thanh-pt/GraduationThesis/Doccument/thePrizeOfThesis.txt

A4988 80+25 = 			105
wire test: 			20
MPU6050 			50
2 DC moto and wheels: 		70
3 5x7 board: 			10
2 wheels robot V3: 		190
2 latches of wheels: 		56
STM32f103 			80
Bluetooth HC05 			85
Thiec han 			50
L293x2 				40
6 5x7 board: 			12
Dip 18 for ic: 			2.8
LM1117: 			7
Tụ Tantalum: 			5
Đế pin: 			10
Pin: 				40
In mạch: 			20
