thanh-pt/GraduationThesis/CircuitDesign/BalanceCarCircuit.PcbDoc.htm

Reporting Options

# File in Previous Format

Date | : | 04/07/2018
Time | : | 09:44:34
Filename | : | E:\MyWork\GraduationThesis\CircuitDesign\BalanceCarCircuit.PcbDoc

Version | Warning
Release 12 | CAUTION - Air Gap Width previously controlled by Clearance rule is now controlled by Polygon Connect Style rule's newly introduced Air Gap Width (set to default value). Suggest reviewing each Polygon Connect Style rule's Air Gap Width attribute for correctness.
Release 13 | CAUTION - Silkscreen Over Component Pads Rules are converted to Silk To Solder Mask Clearance Rules. Suggest examining rule scopes for accuracy.

This file was generated by an earlier version of the software
