thanh-pt/GraduationThesis/Slide/GraduationThesisSlide.pptx

ĐẠI HỌC QUỐC GIA HÀ NỘI
TRƯỜNG ĐẠI HỌC CÔNG NGHỆ
LỄ BẢO VỆ KHÓA LUẬN TỐT NGHIỆP ĐẠI HỌC CHÍNH QUY
TRƯỜNG ĐẠI HỌC CÔNG NGHỆ ĐỢT 1 2018
NGHIÊN CỨU, THIẾT KẾ XE TỰ CÂN BẰNG
SỬ DỤNG CẢM BIẾN GIA TỐC 3 TRỤC
VÀ VI ĐIỀU KHIỂN 32 BIT
Sinh viên: Phạm Tiến Thành
Giảng viên hướng dẫn: ThS. Hoàng Văn Mạnh

## Mở đầu

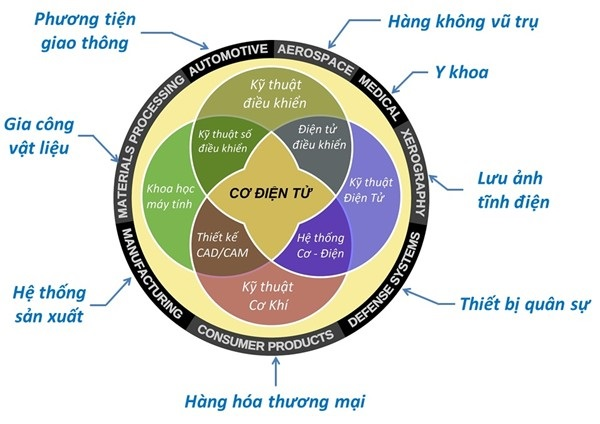
[picture p1: figure]
Image result for CÆ¡ Ä iá» n tá»

## Mở đầu

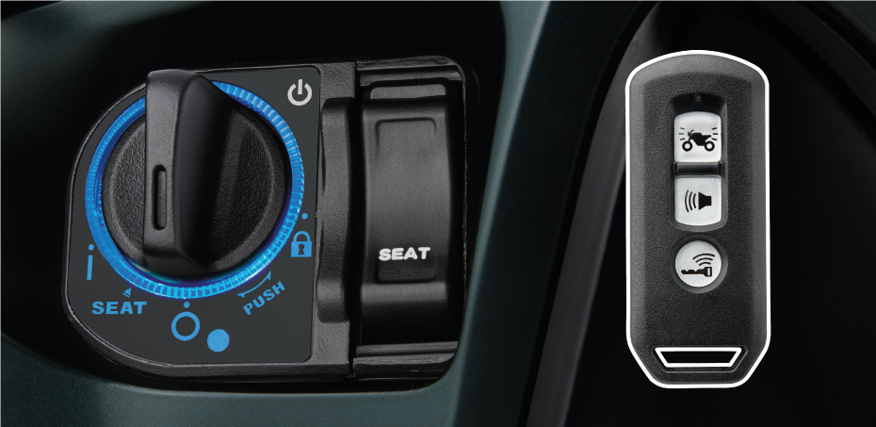
[picture p2: figure]
Image result for xe mÃ¡y thÃ´ng minh
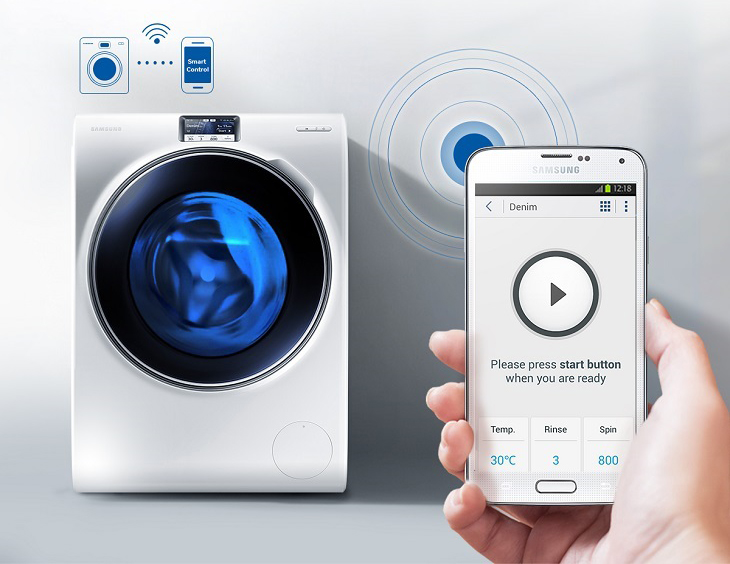
[picture p3: figure]
Image result for mÃ¡y giáº·t thÃ´ng minh
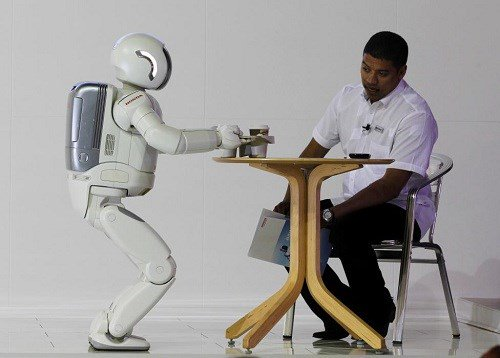
[picture p4: figure]
Image result for robot thÃ´ng minh

## Cảm biến

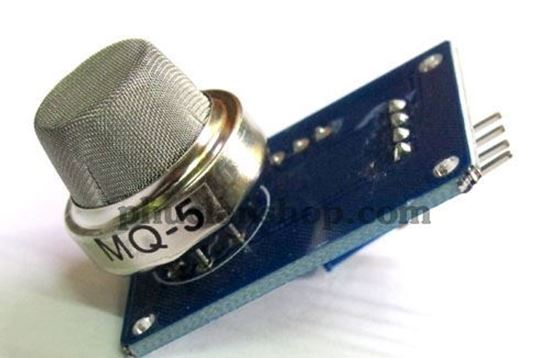
[picture p5: figure]
Image result for cáº£m biáº¿n
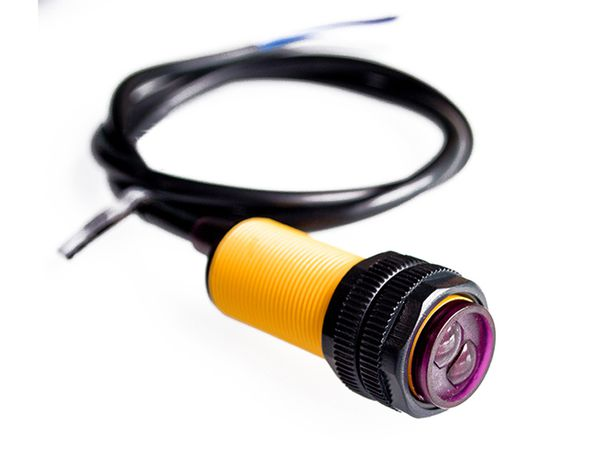
[picture p6: figure]
Image result for cáº£m biáº¿n
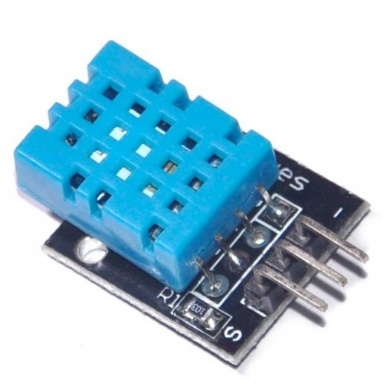
[picture p7: figure]
Image result for cáº£m biáº¿n
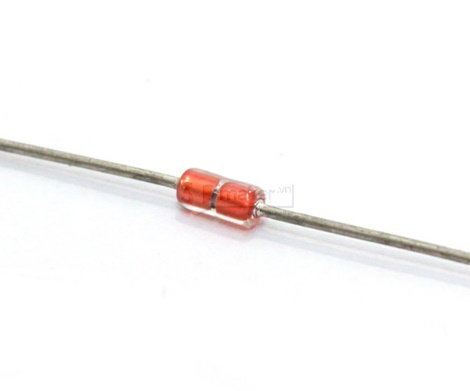
[picture p8: figure]
Image result for cáº£m biáº¿n
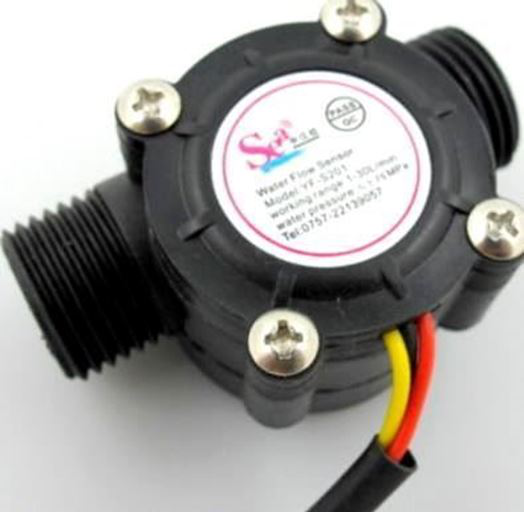
[picture p9: figure]
Image result for cáº£m biáº¿n
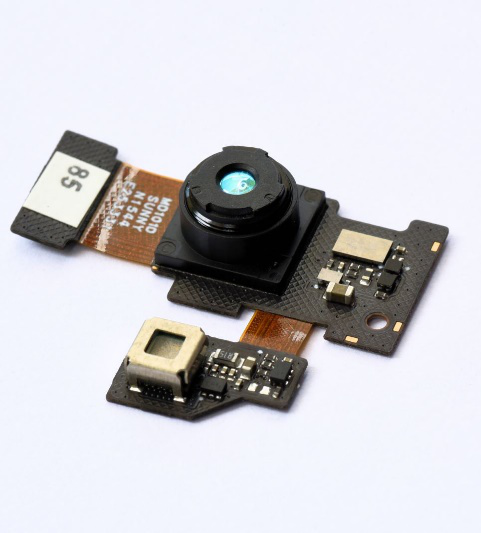
[picture p10: figure]
Image result for cáº£m biáº¿n
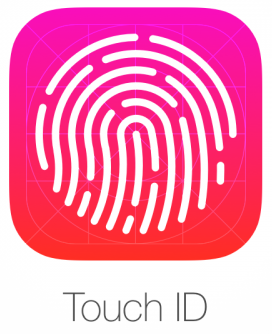
[picture p11: figure]
Image result for cáº£m biáº¿n vÃ¢n tay
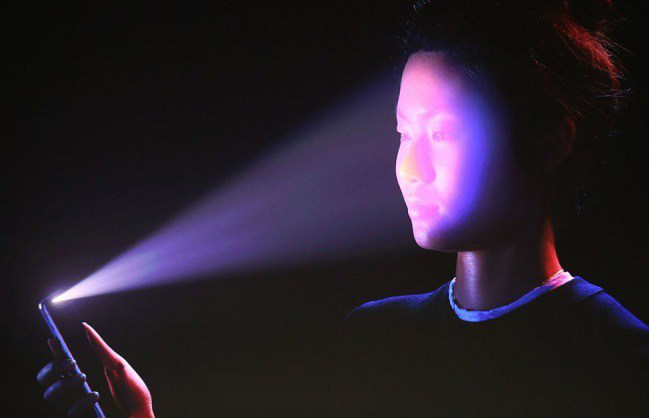
[picture p12: figure]
Image result for cáº£m biáº¿n face id
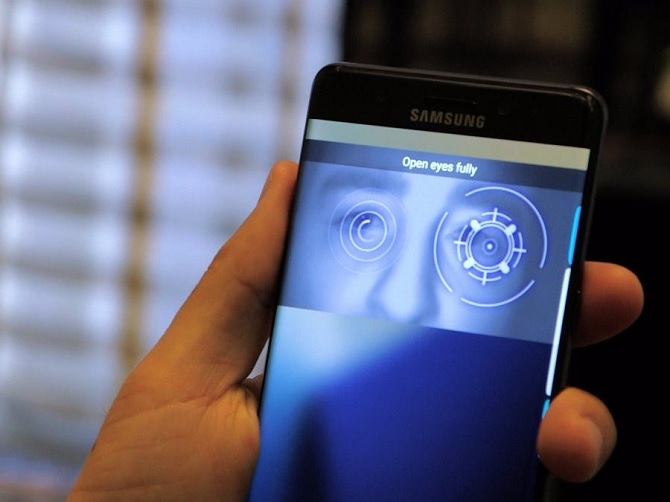
[picture p13: figure]
Image result for cáº£m biáº¿n má» ng máº¯t

## Cảm biến gia tốc 3 trục

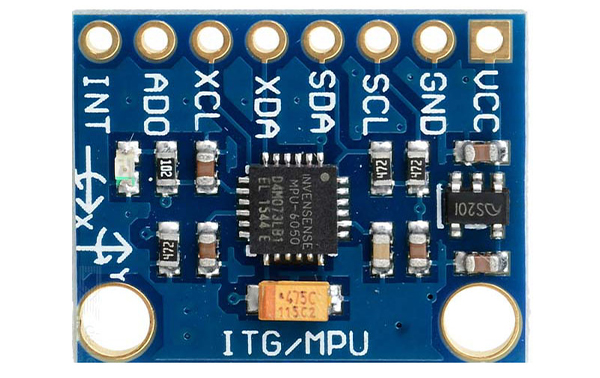
[picture p14: figure]
Image result for cáº£m biáº¿n gia tá» c 3 trá»¥c

## Vi điều khiển

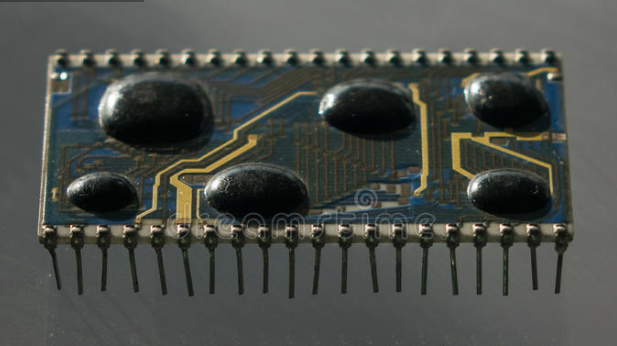
[picture p15: figure]
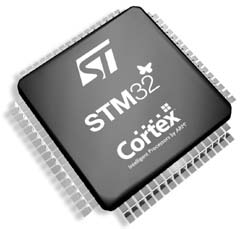
[picture p16: figure]
Image result for 32bit microcontroller

## Vi điều khiển 32 bit

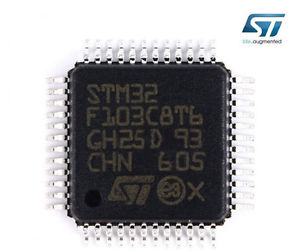
[picture p17: figure]
Image result for stm32f103c8t6 chip only

## Vi điều khiển 32 bit

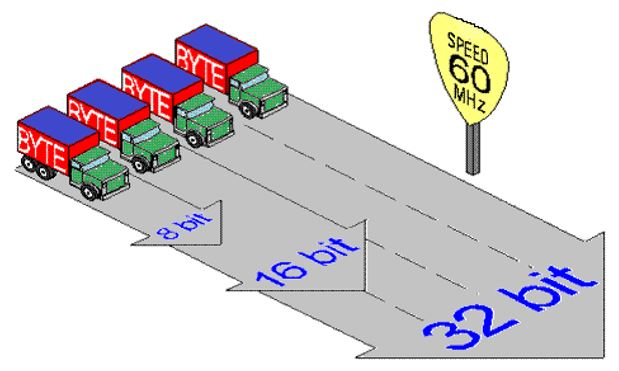
[picture p18: figure]
Architecture Valuable Idea 8 Bit Microcontroller Architecture And 32 Microcontrollers Theembeddedguy Com MCU WellSuited Design 8 Bit Microcontroller Architecture

## Vi điều khiển 32 bit

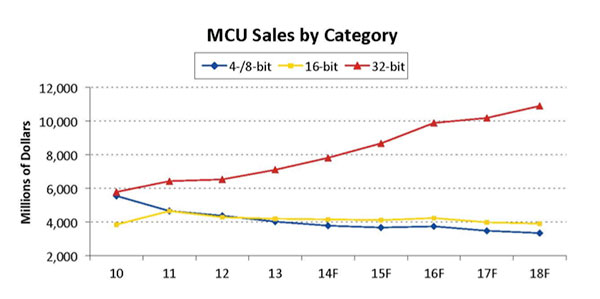
[picture p19: figure]
fig1

## Vi điều khiển 32 bit

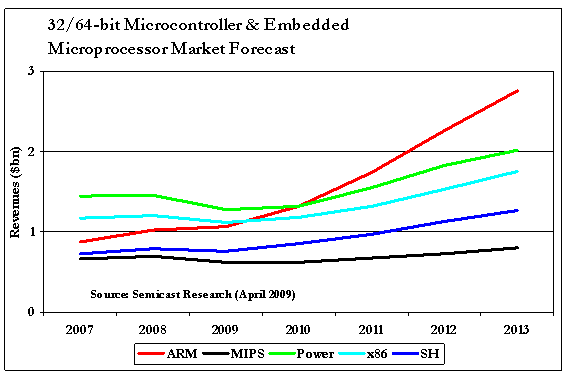
[picture p20: figure]
Architecture Shocking Ideas 8 Bit Microcontroller Architecture ARM Forecast To Become The Leading 32 Source Material For This News Release Is Taken From Semicast Report 64 Microcontrollers Embedded WellSuited Design 8 Bit Microcontroller Architecture

## Xe hai bánh tự cân bằng

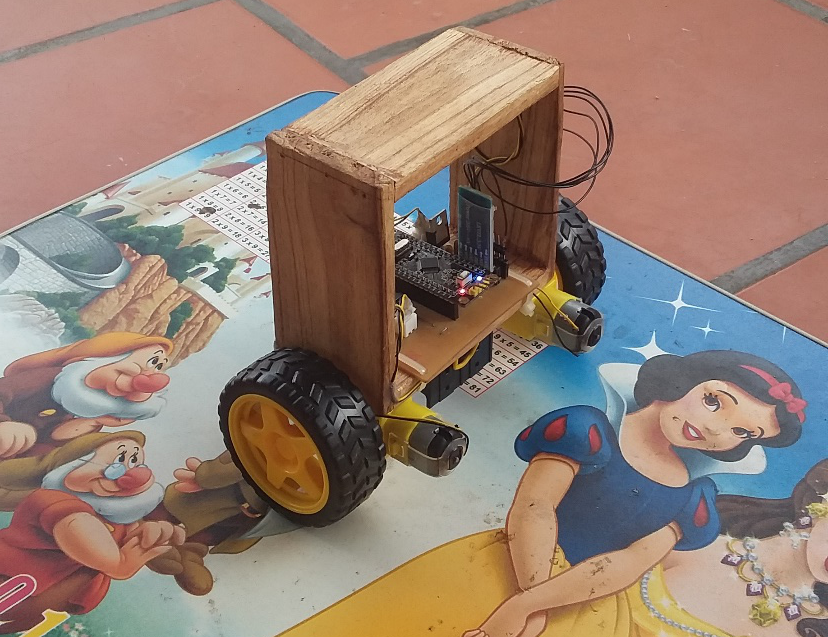
[picture p21: figure]

## Xe hai bánh tự cân bằng

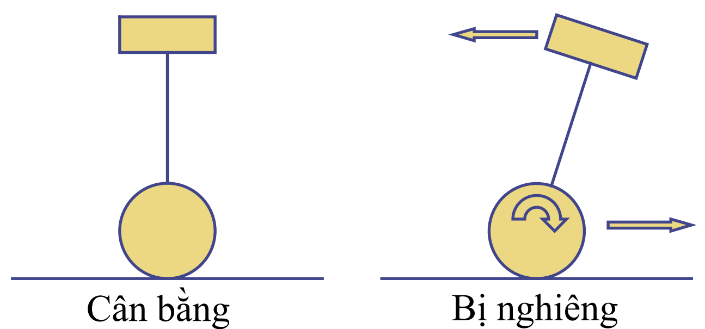
[picture p22: figure]
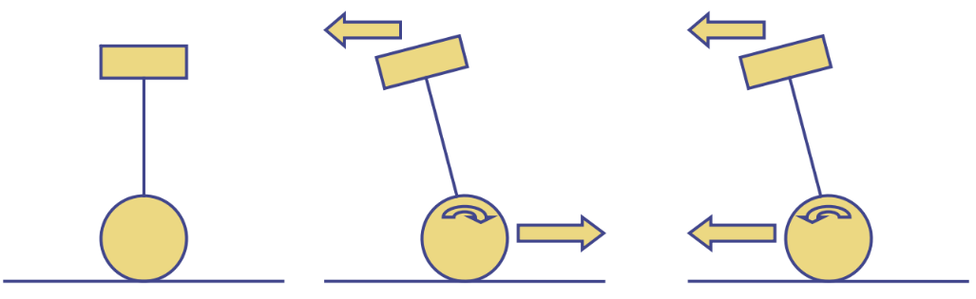
[picture p23: figure]

Phương thức di chuyển

## Xe hai bánh tự cân bằng

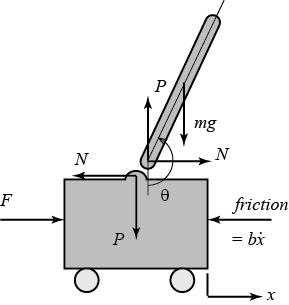
[picture p24: figure]

## Thiết kế, chế tạo xe tự cân bằng

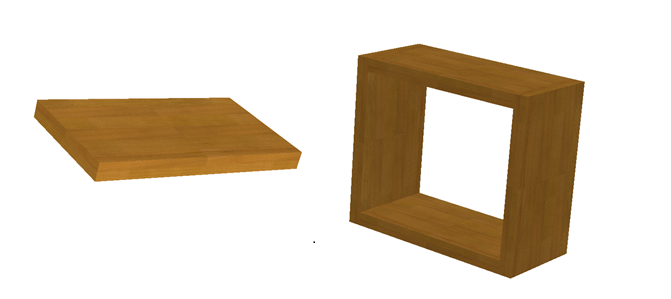
[picture p25: figure]
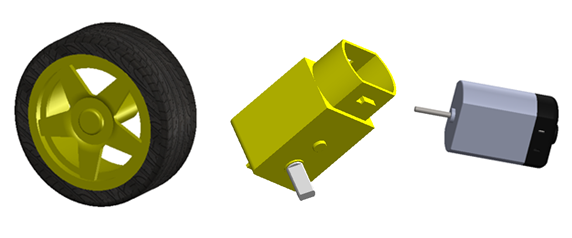
[picture p26: figure]
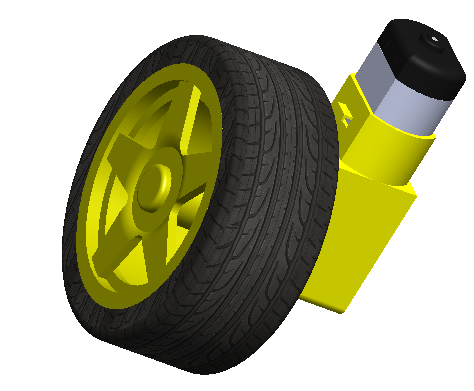
[picture p27: figure]
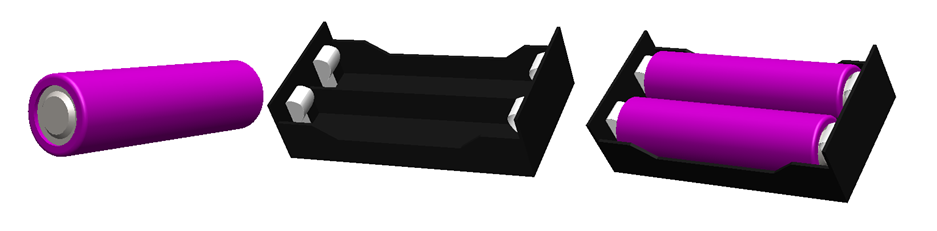
[picture p28: figure]

## Thiết kế, chế tạo xe tự cân bằng

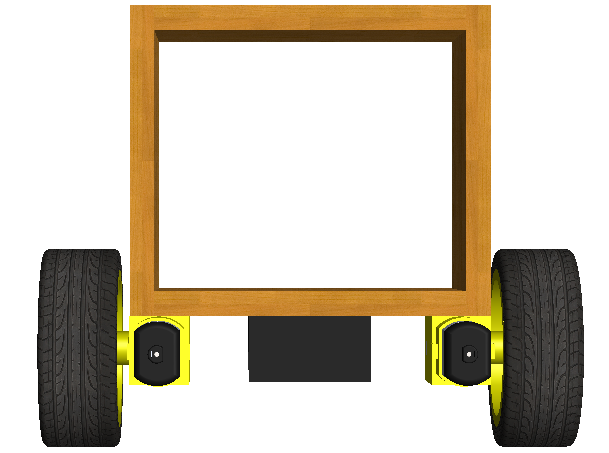
[picture p29: figure]
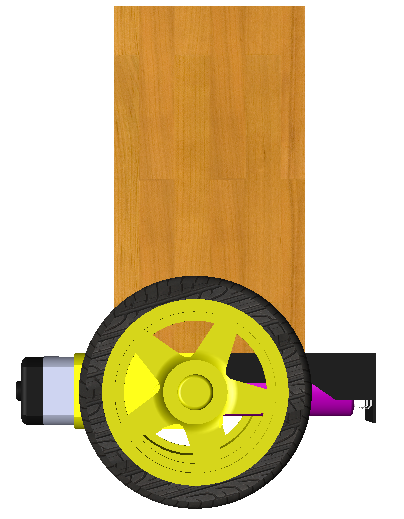
[picture p30: figure]

## Thiết kế, chế tạo xe tự cân bằng

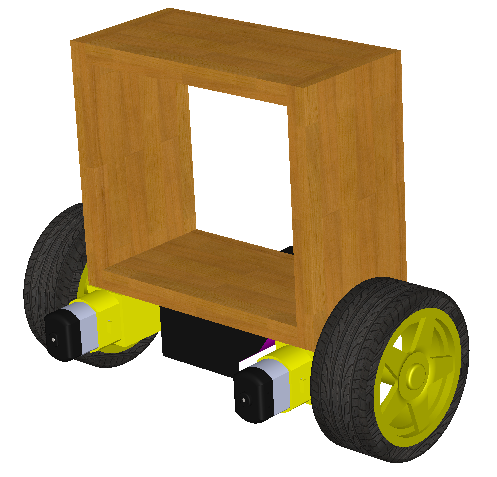
[picture p31: figure]

## Thiết kế, chế tạo xe tự cân bằng

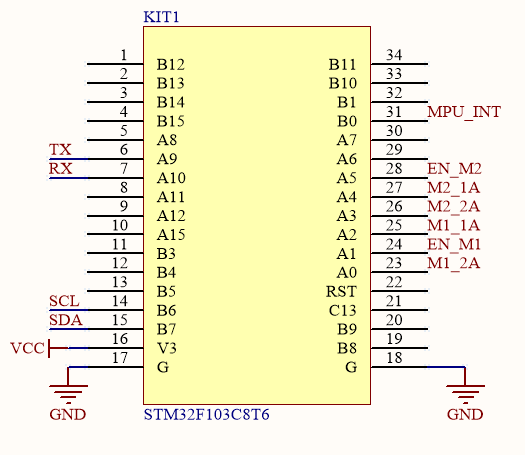
[picture p32: figure]

Vi điều khiển

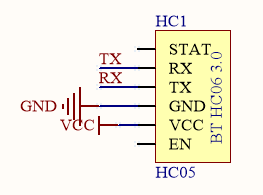
[picture p33: figure]

Bluetooth

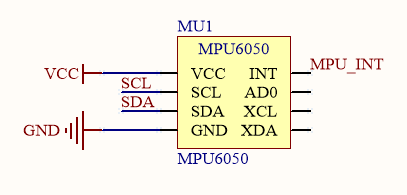
[picture p34: figure]

MPU6050

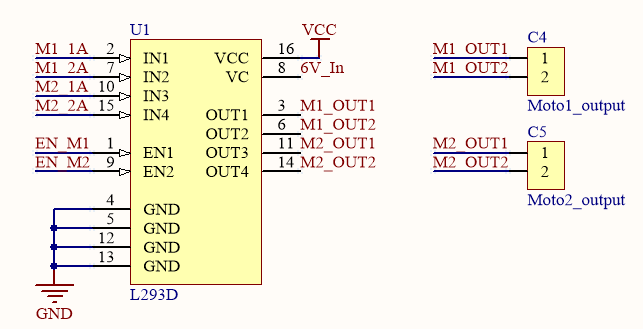
[picture p35: figure]
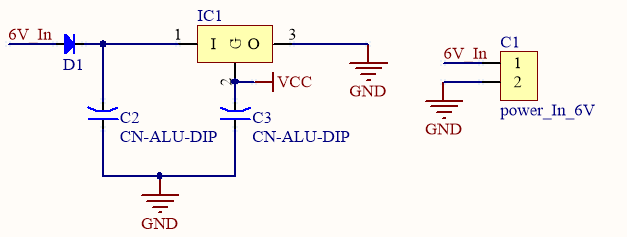
[picture p36: figure]

Khối nguồn

IC L293

## Thiết kế, chế tạo xe tự cân bằng

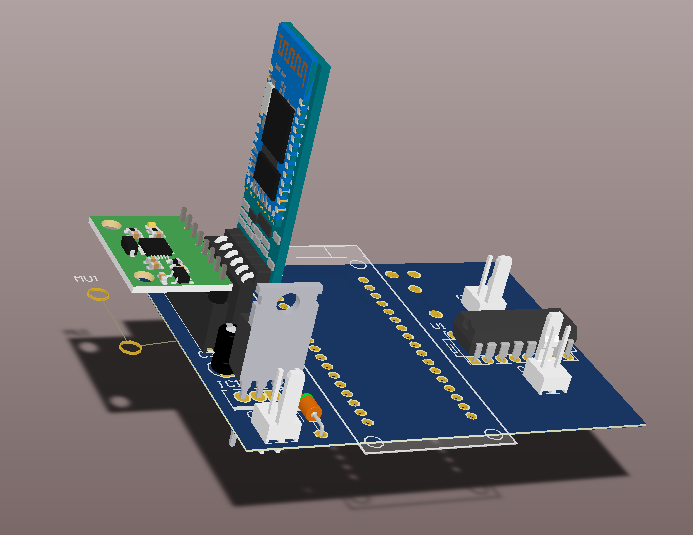
[picture p37: figure]
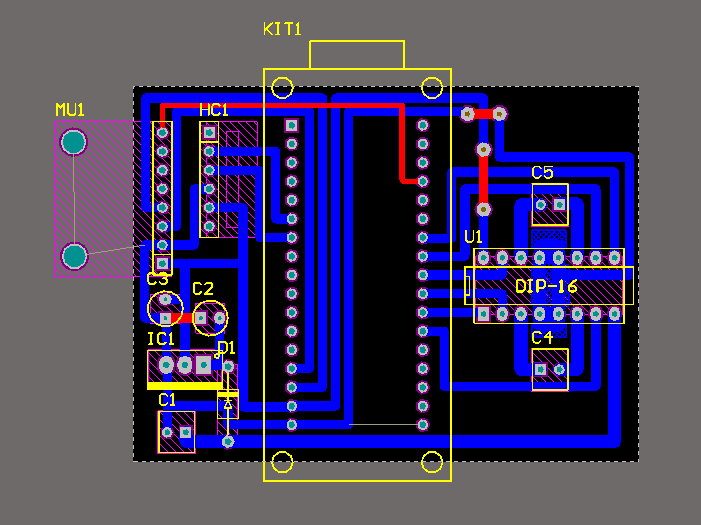
[picture p38: figure]

## Thiết kế, chế tạo xe tự cân bằng

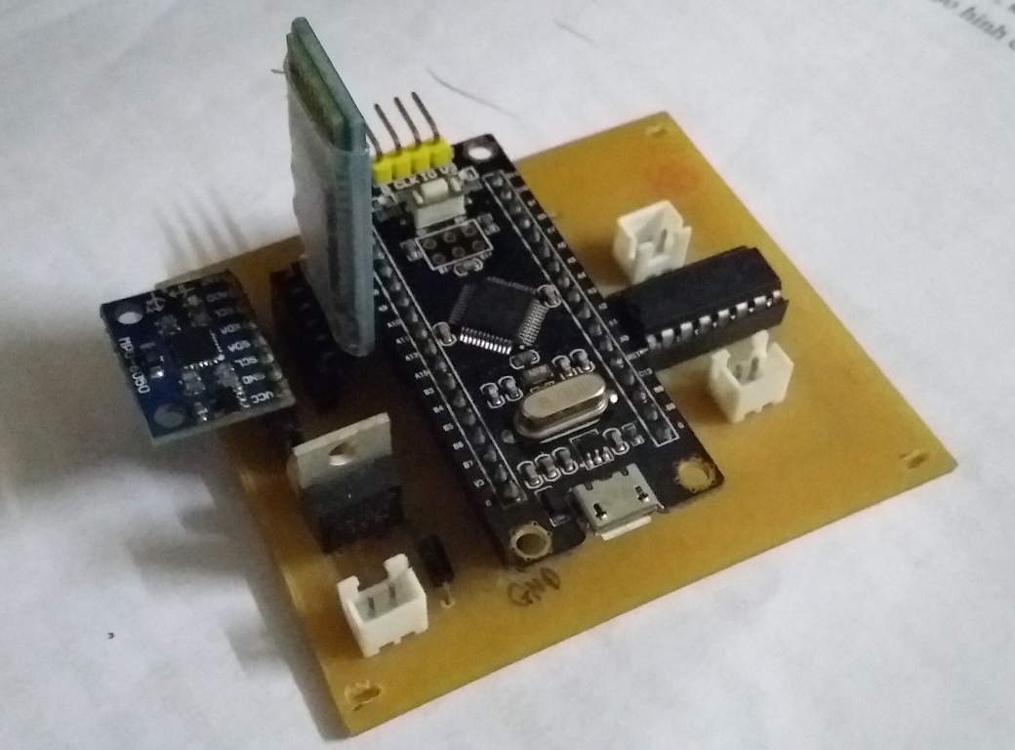
[picture p39: figure]
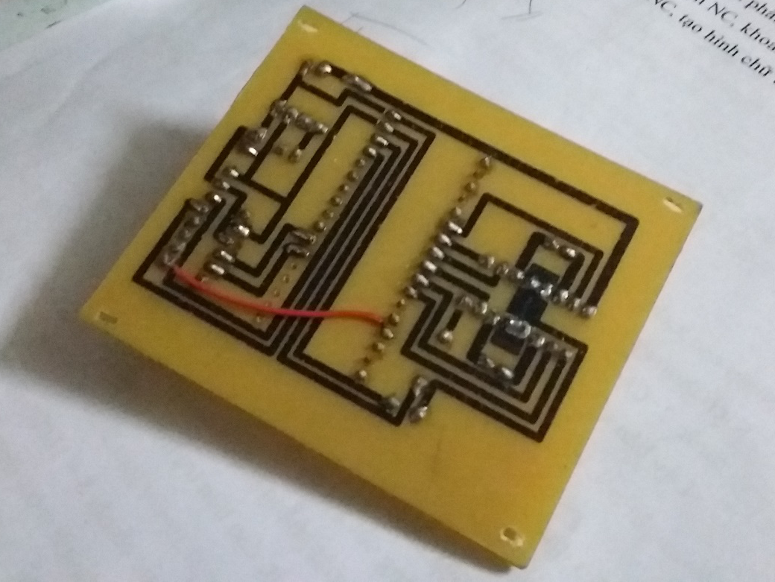
[picture p40: figure]

## Thiết kế, chế tạo xe tự cân bằng

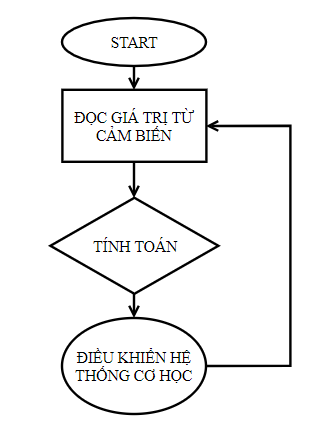
[picture p41: figure]

Thuật toán giữ xe tự cân bằng

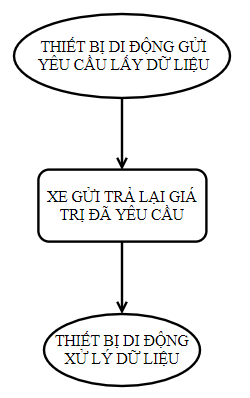
[picture p42: figure]

lấy dữ liệu từ xe cân bằng

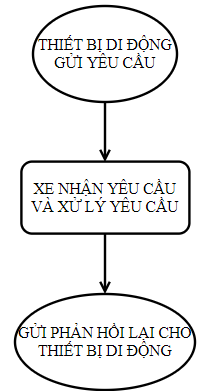
[picture p43: figure]

điều khiển xe tự cân bằng

## Kết luận

## Cảm ơn quý thầy cô và các bạn!
