thanh-pt/GraduationThesis/AppControl/BalanceCarControl/png/arrow.png

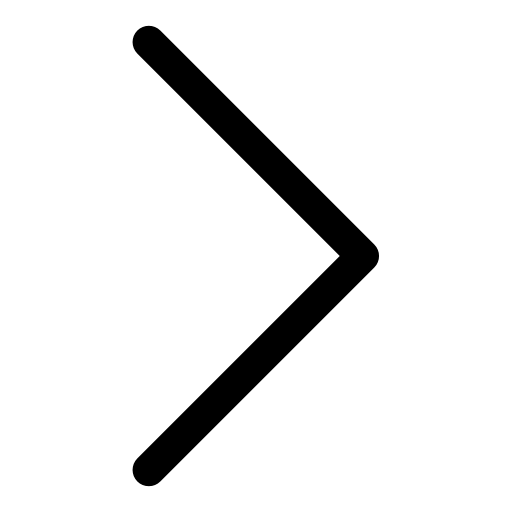
AppControl/BalanceCarControl/png/arrow.png
