thanh-pt/GraduationThesis/AppControl/BalanceCarControl/png/bluetooth.png

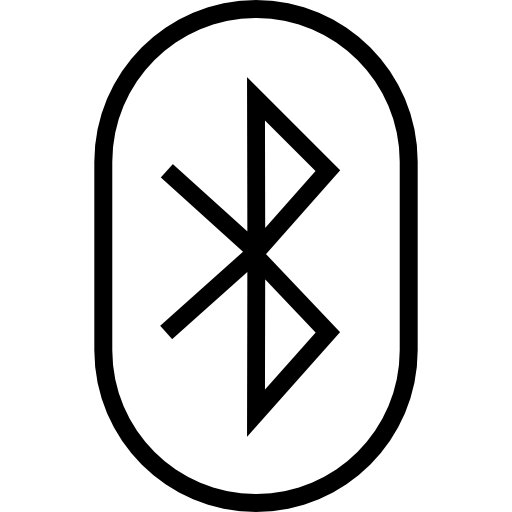
AppControl/BalanceCarControl/png/bluetooth.png
