thanh-pt/GraduationThesis/AppControl/BalanceCarControl/png/control_app.png

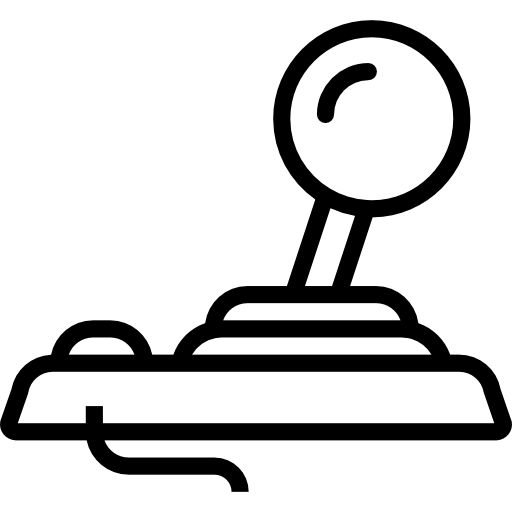
AppControl/BalanceCarControl/png/control_app.png
