thanh-pt/GraduationThesis/AppControl/BalanceCarControl/png/filter.png

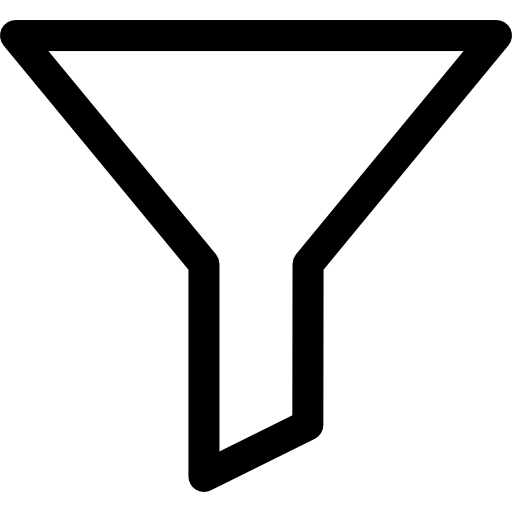
AppControl/BalanceCarControl/png/filter.png
