thanh-pt/GraduationThesis/AppControl/BalanceCarControl/png/info.png

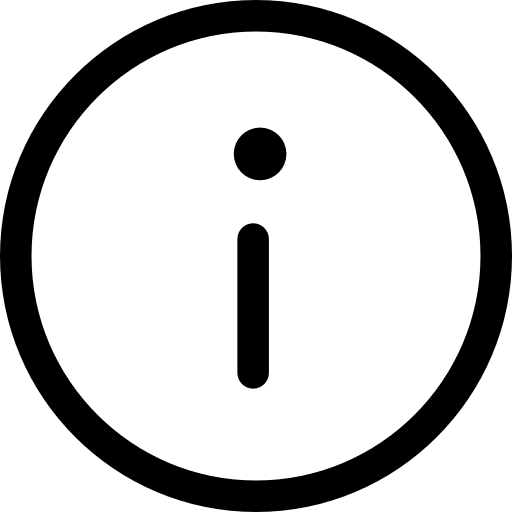
AppControl/BalanceCarControl/png/info.png
