thanh-pt/GraduationThesis/AppControl/BalanceCarControl/png/menu.png

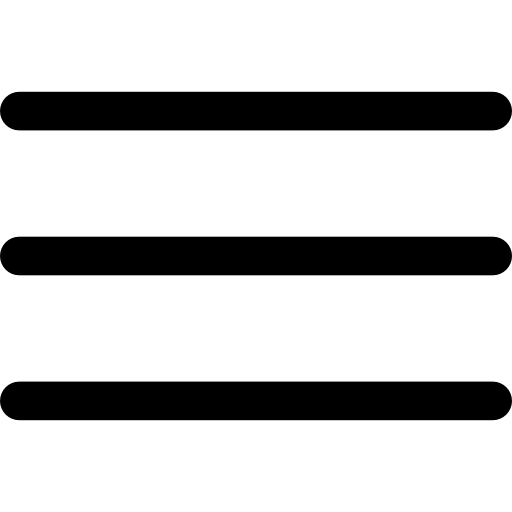
AppControl/BalanceCarControl/png/menu.png
