thanh-pt/GraduationThesis/AppControl/BalanceCarControl/png/mpu6050.png

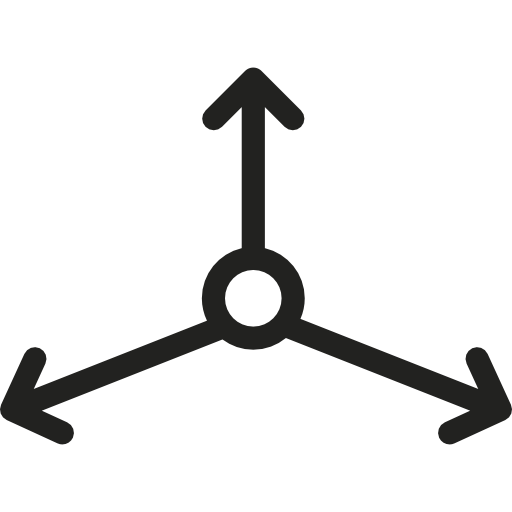
AppControl/BalanceCarControl/png/mpu6050.png
