thanh-pt/GraduationThesis/AppControl/BalanceCarControl/png/switch_n.png

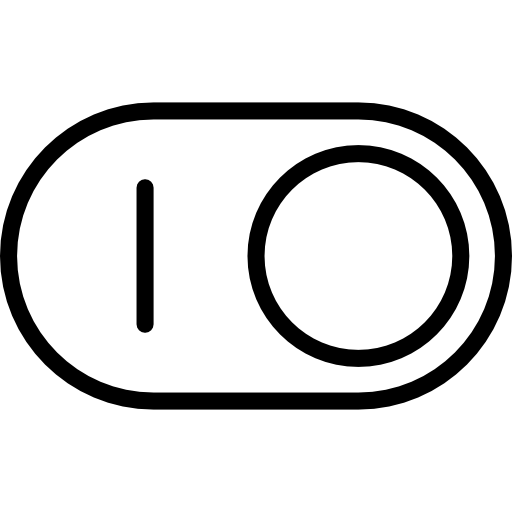
AppControl/BalanceCarControl/png/switch_n.png
