thanh-pt/GraduationThesis/AppControl/BalanceCarControl/png/switch_s.png

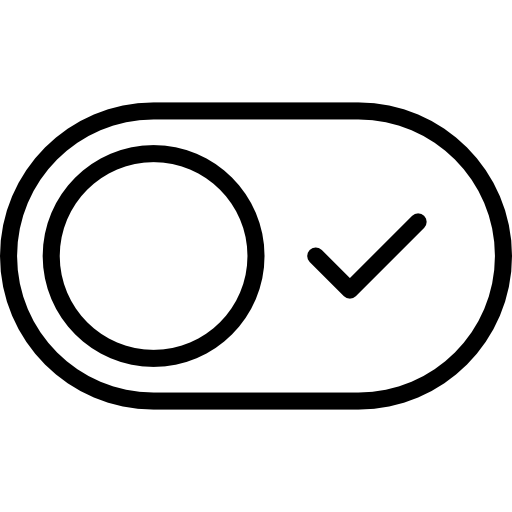
AppControl/BalanceCarControl/png/switch_s.png
