thanh-pt/GraduationThesis/MotoModel/Gear.SLDASM

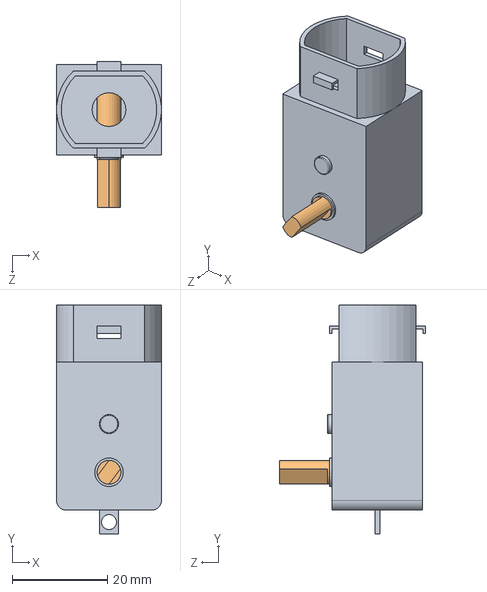
[picture p132: CAD file, 2018-04-25]
MotoModel/Gear.SLDASM
22.0 x 48.0 x 30.6 mm
MotoGear
MotoAxis
