thanh-pt/GraduationThesis/MotoModel/pinCaseFull.SLDPRT.SLDASM

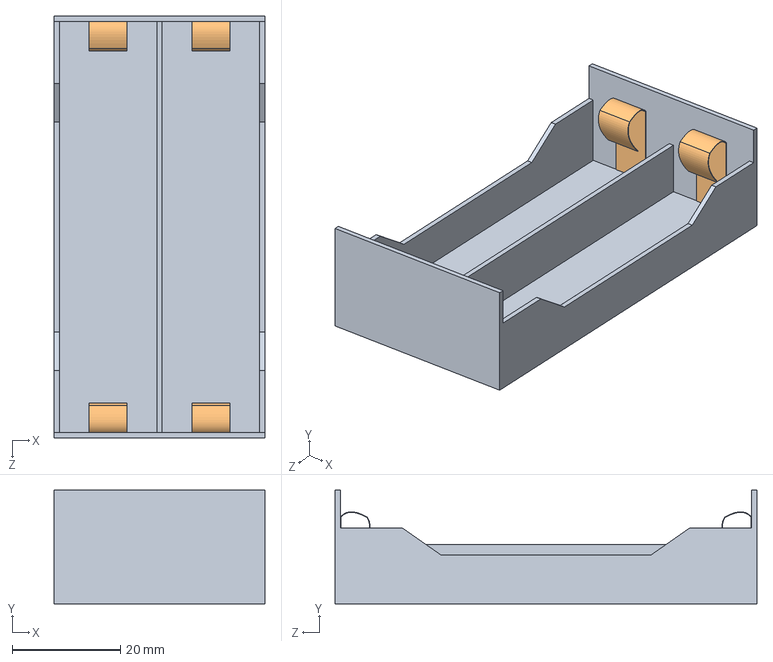
[picture p133: CAD file, 2018-04-25]
MotoModel/pinCaseFull.SLDPRT.SLDASM
39.0 x 21.0 x 78.0 mm
pinCase
pinCase_iron x 4
