thanh-pt/GraduationThesis/MotoModel/BalanceCar.SLDASM

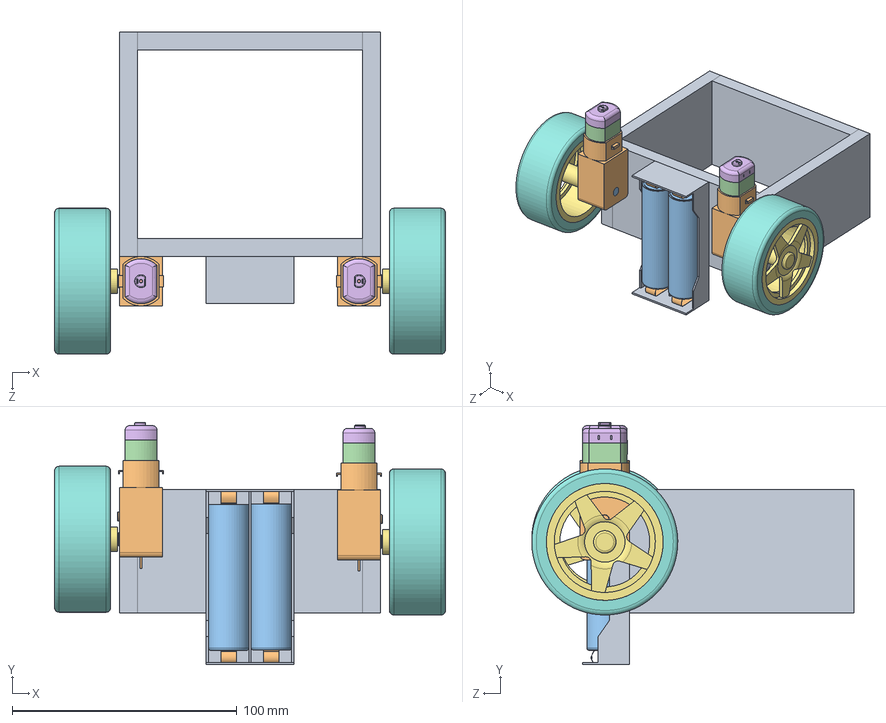
[picture p134: CAD file, 2018-04-25]
MotoModel/BalanceCar.SLDASM
174.0 x 107.9 x 143.5 mm
HorizontalPlat x 4
MotoGear x 2
MotoAxis x 2
moto_box x 2
moto_axis x 2
moto_back x 2
WheelCore x 2
WheelTire x 2
pinCase
pinCase_iron x 4
pin x 2
