thanh-pt/GraduationThesis/MotoModel/Wheel.SLDASM

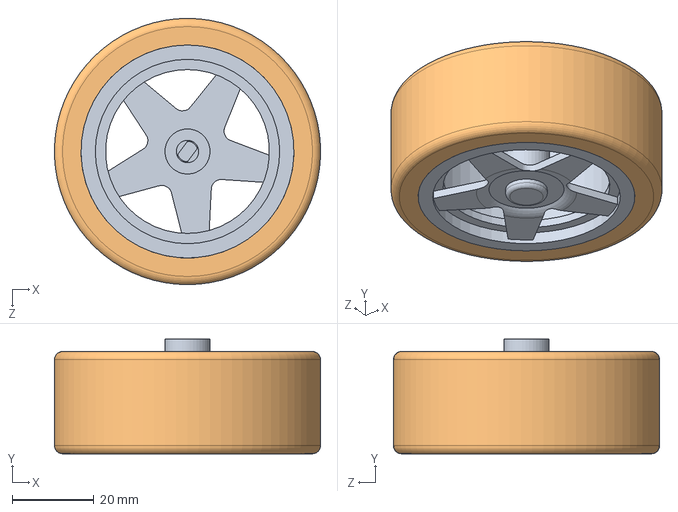
[picture p135: CAD file, 2018-04-25]
MotoModel/Wheel.SLDASM
64.9 x 28.0 x 65.0 mm
WheelCore
WheelTire
