thanh-pt/GraduationThesis/MotoModel/moto.SLDASM

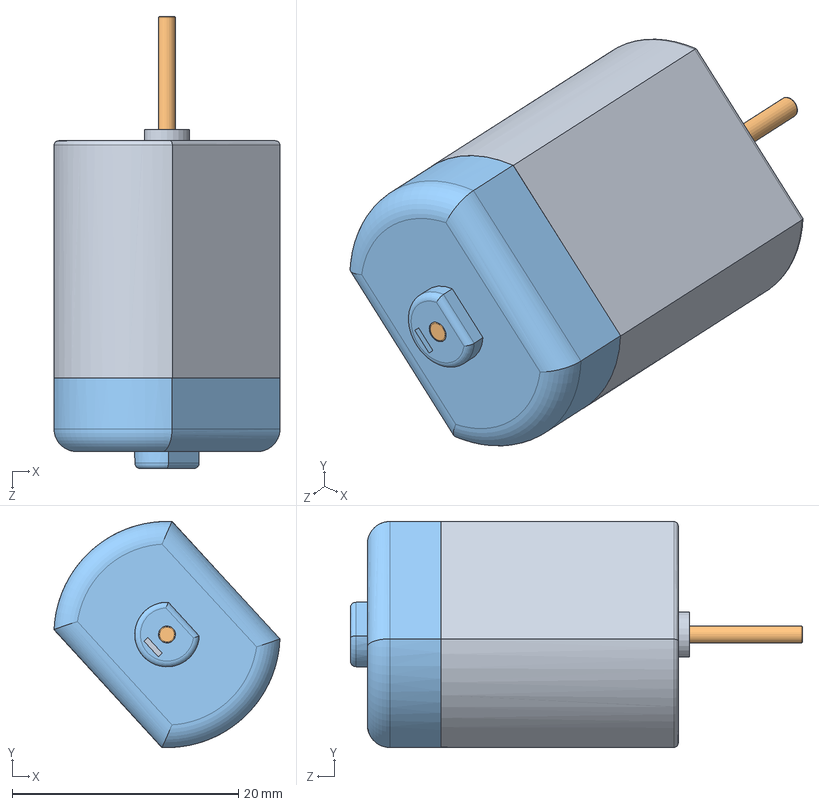
[picture p136: CAD file, 2018-04-25]
MotoModel/moto.SLDASM
20.0 x 20.0 x 40.0 mm
moto_box
moto_axis
moto_back
