thanh-pt/GraduationThesis/MotoModel/Gear_Moto_Wheel.SLDASM

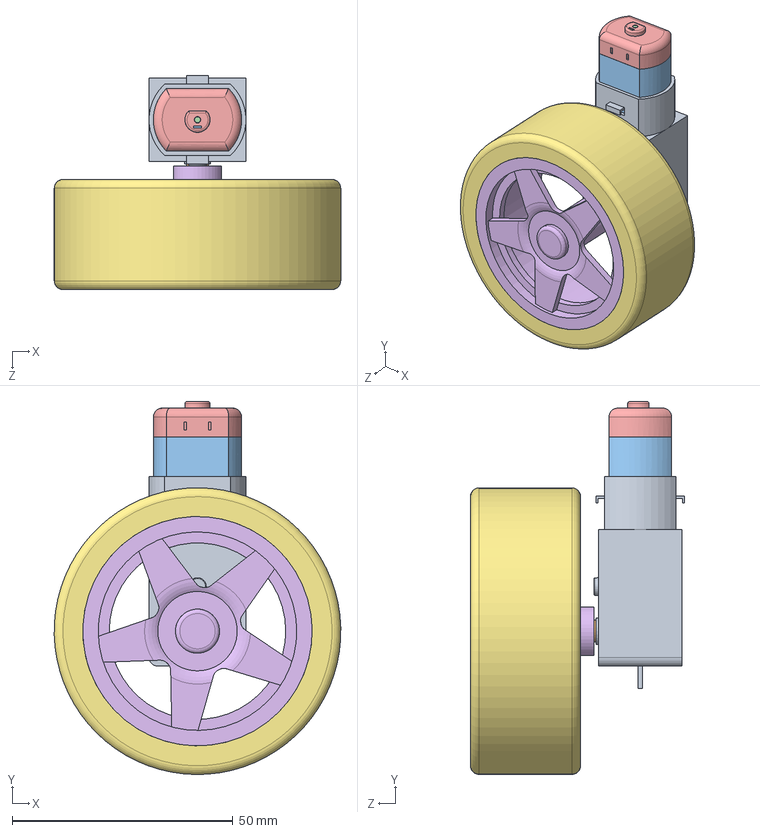
[picture p137: CAD file, 2018-04-25]
MotoModel/Gear_Moto_Wheel.SLDASM
65.0 x 84.6 x 48.6 mm
MotoGear
MotoAxis
moto_box
moto_axis
moto_back
WheelCore
WheelTire
