thanh-pt/GraduationThesis/MotoModel/pinFull.SLDASM

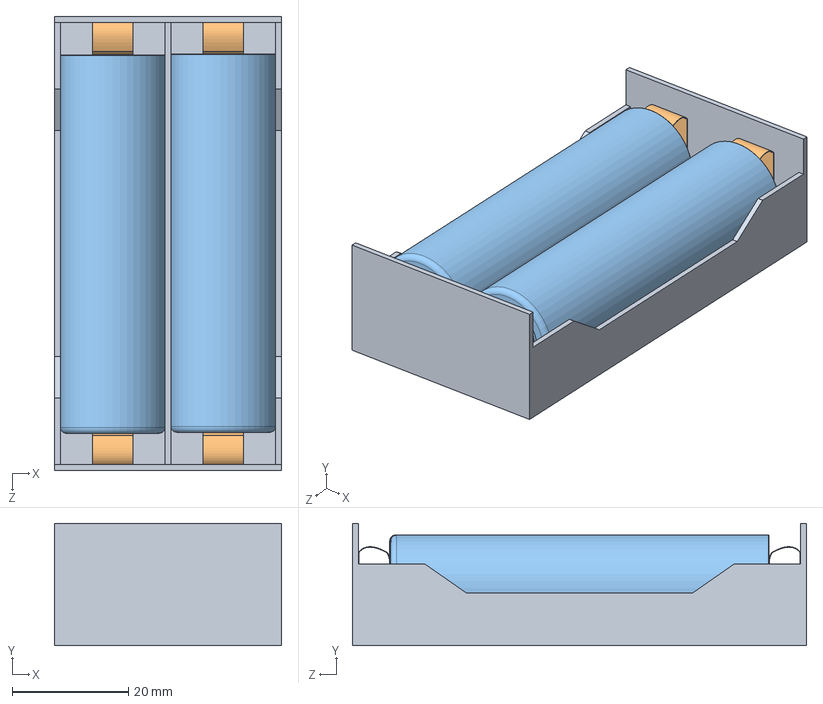
[picture p138: CAD file, 2018-04-25]
MotoModel/pinFull.SLDASM
39.0 x 21.0 x 78.0 mm
pinCase
pinCase_iron x 4
pin x 2
