thanh-pt/GraduationThesis/MotoModel/Gear_Moto.SLDASM

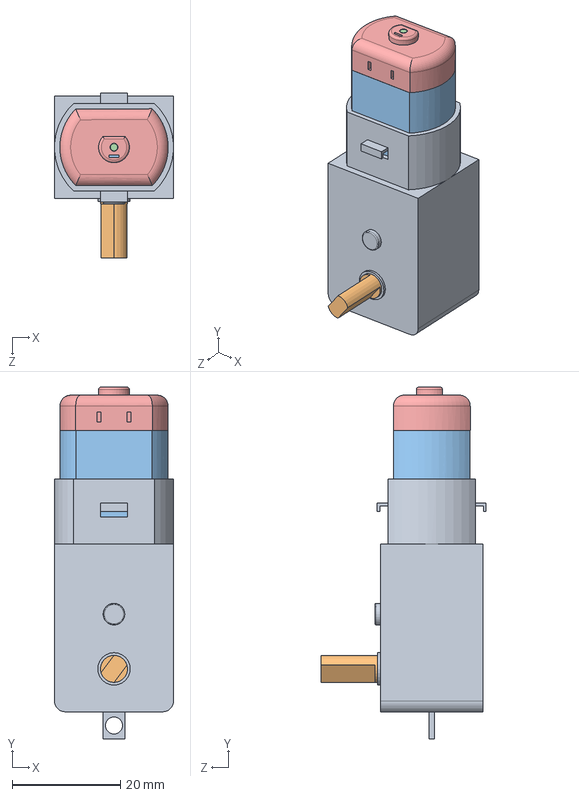
[picture p139: CAD file, 2018-04-25]
MotoModel/Gear_Moto.SLDASM
22.0 x 65.0 x 30.6 mm
MotoGear
MotoAxis
moto_box
moto_axis
moto_back
