thanh-pt/GraduationThesis/MotoModel/frame.SLDASM

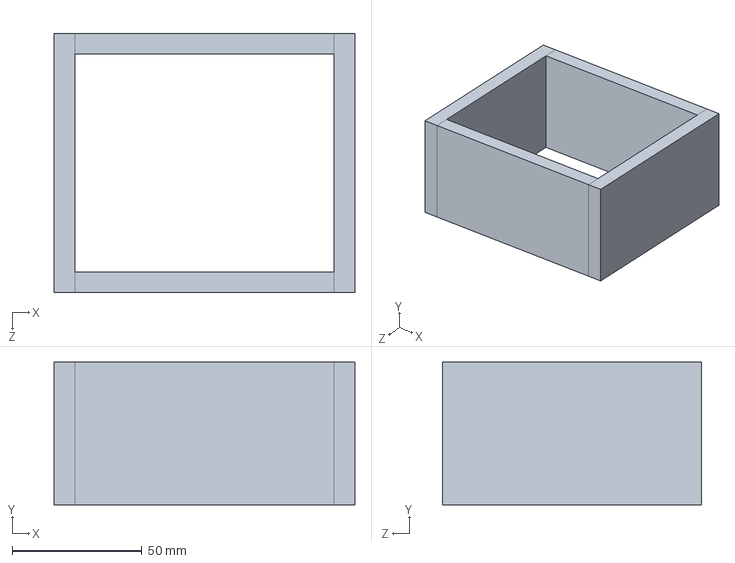
[picture p140: CAD file, 2018-04-25]
MotoModel/frame.SLDASM
116.0 x 55.0 x 100.0 mm
HorizontalPlat x 4
