thanh-pt/GraduationThesis/MotoModel/moto_back.SLDPRT

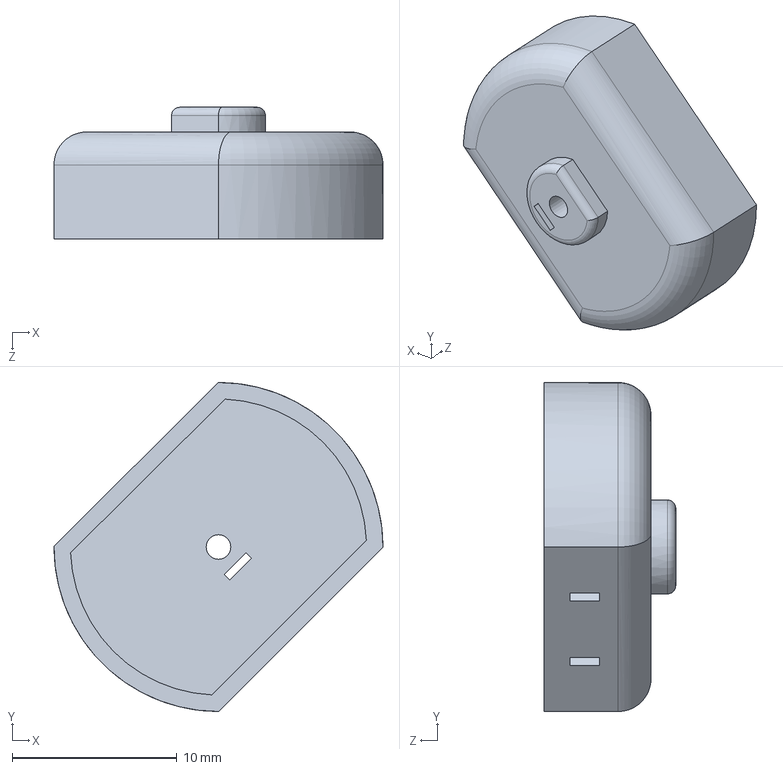
[picture p141: CAD file, 2018-04-25]
MotoModel/moto_back.SLDPRT
20.0 x 20.0 x 8.00 mm
