thanh-pt/GraduationThesis/MotoModel/pin.SLDPRT

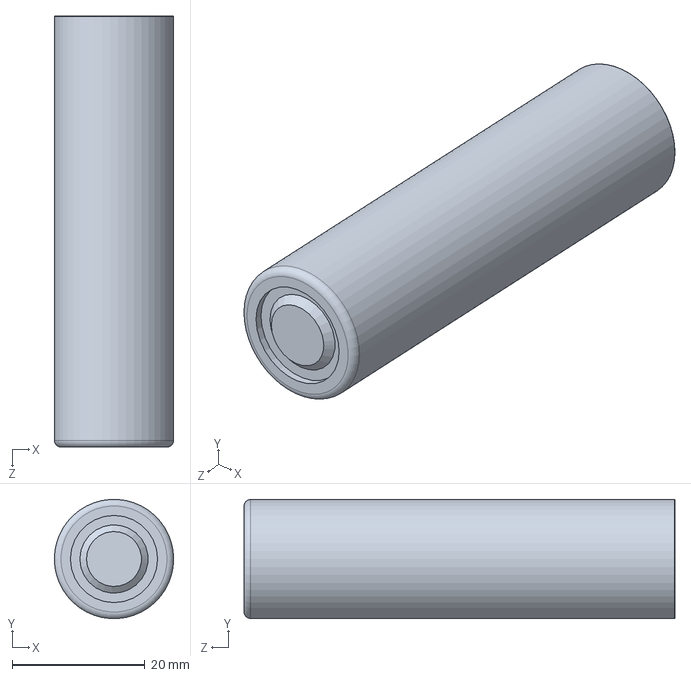
[picture p142: CAD file, 2018-04-25]
MotoModel/pin.SLDPRT
18.0 x 18.0 x 65.0 mm
