thanh-pt/GraduationThesis/MotoModel/MotoAxis.SLDPRT

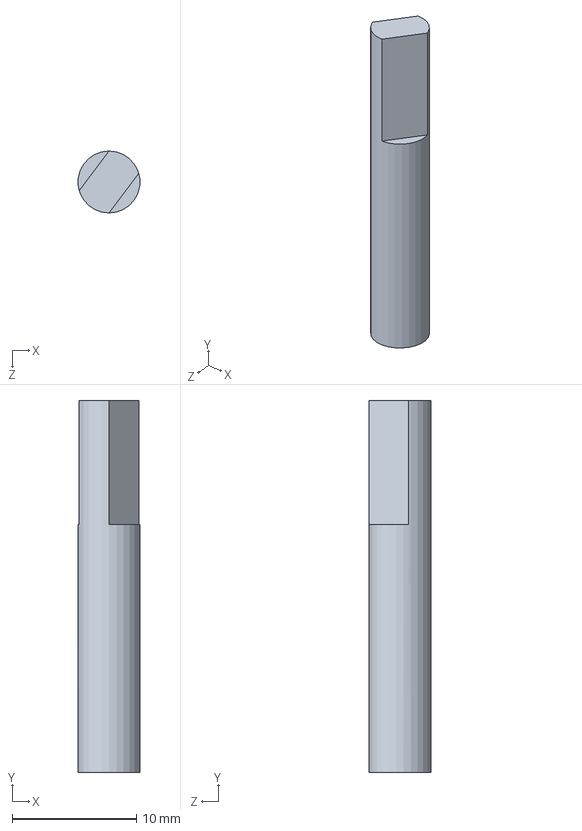
[picture p143: CAD file, 2018-04-25]
MotoModel/MotoAxis.SLDPRT
4.96 x 30.0 x 5.00 mm
