thanh-pt/GraduationThesis/MotoModel/pinCase.SLDPRT

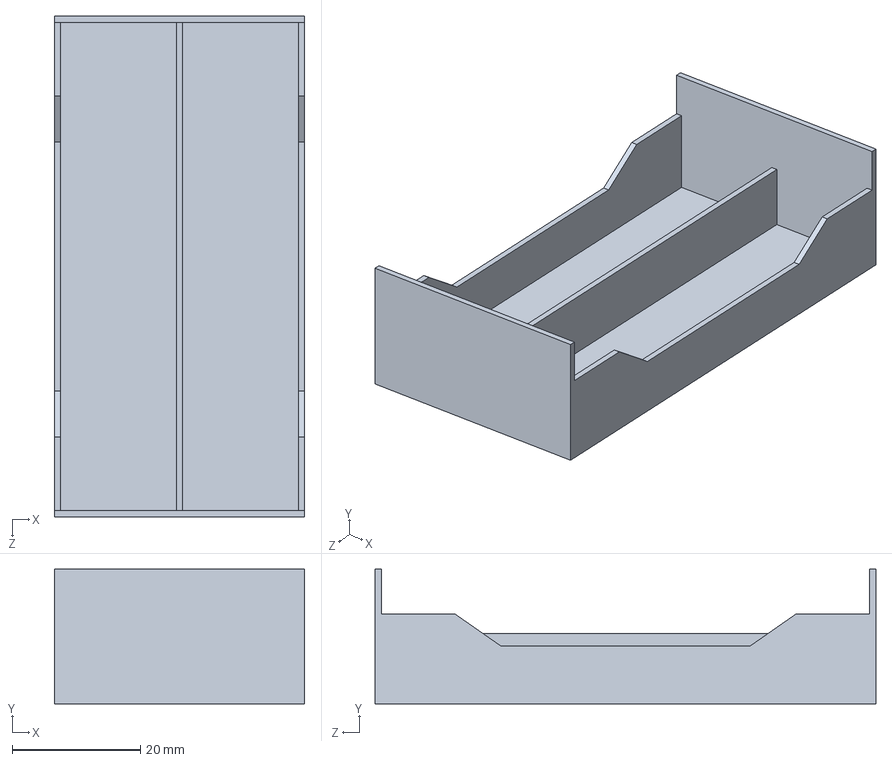
[picture p144: CAD file, 2018-04-25]
MotoModel/pinCase.SLDPRT
39.0 x 21.0 x 78.0 mm
