thanh-pt/GraduationThesis/MotoModel/MotoGear.SLDPRT

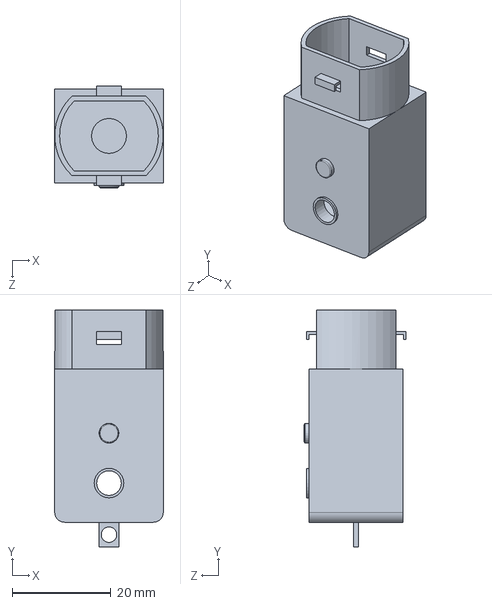
[picture p145: CAD file, 2018-04-25]
MotoModel/MotoGear.SLDPRT
22.0 x 48.0 x 20.6 mm
