thanh-pt/GraduationThesis/MotoModel/WheelTire.SLDPRT

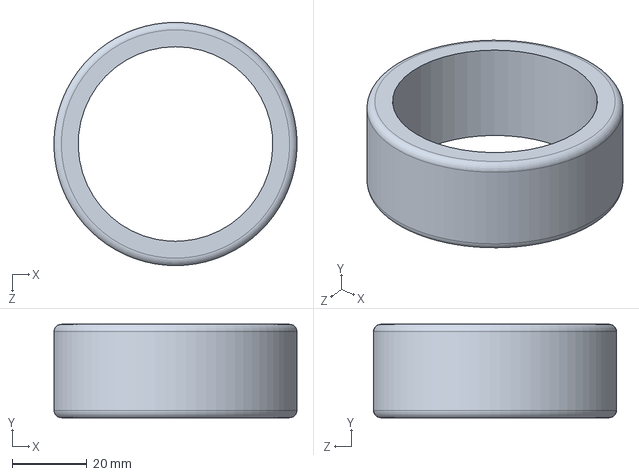
[picture p146: CAD file, 2018-04-25]
MotoModel/WheelTire.SLDPRT
64.9 x 25.0 x 65.0 mm
