thanh-pt/GraduationThesis/MotoModel/moto_box.SLDPRT

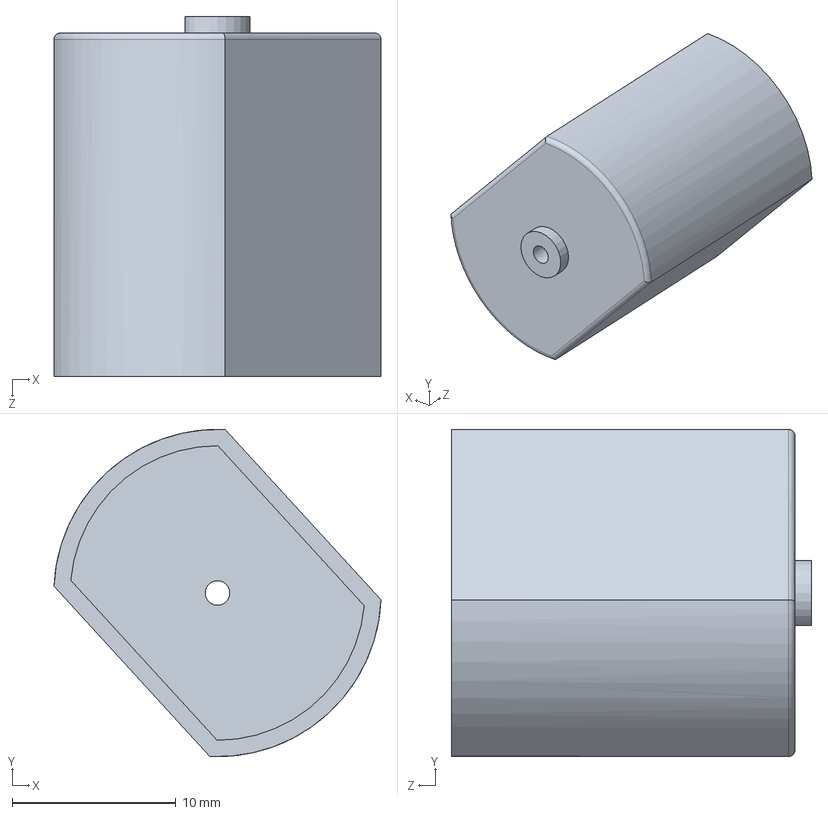
[picture p147: CAD file, 2018-04-25]
MotoModel/moto_box.SLDPRT
20.0 x 20.0 x 22.0 mm
