thanh-pt/GraduationThesis/MotoModel/HorizontalPlat.SLDPRT

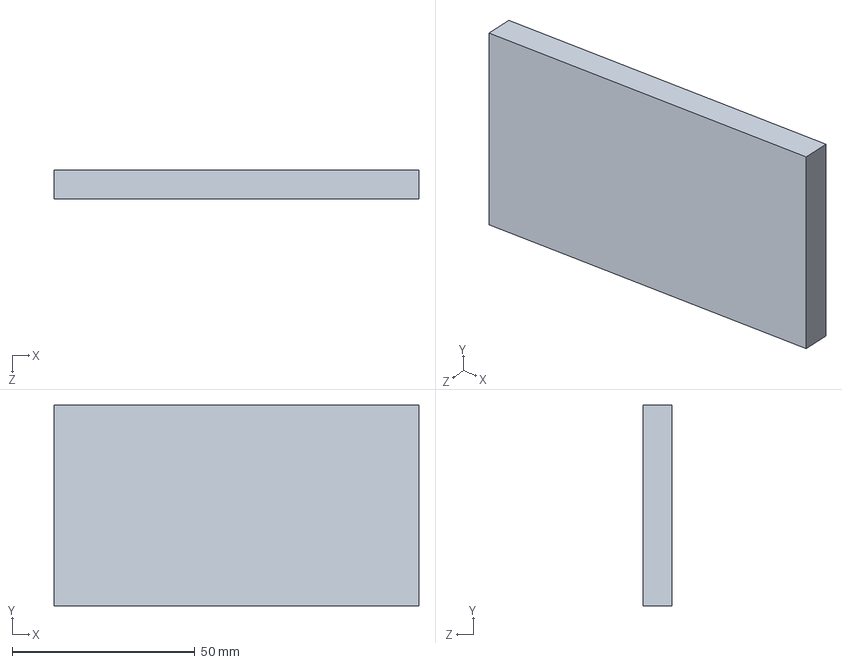
[picture p148: CAD file, 2018-04-25]
MotoModel/HorizontalPlat.SLDPRT
100.0 x 55.0 x 8.00 mm
