thanh-pt/GraduationThesis/MotoModel/pinCase_iron.SLDPRT

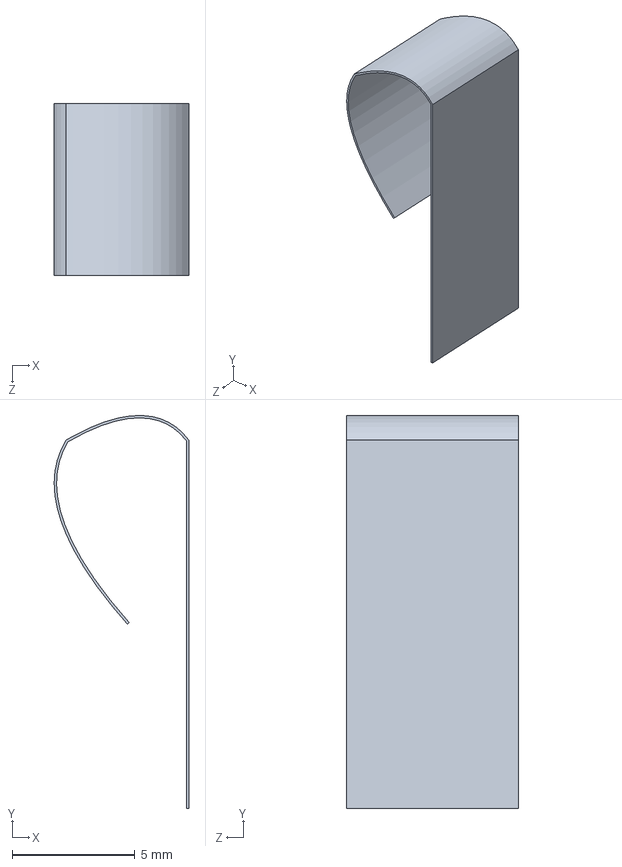
[picture p149: CAD file, 2018-04-25]
MotoModel/pinCase_iron.SLDPRT
5.49 x 16.0 x 7.00 mm
