thanh-pt/GraduationThesis/MotoModel/WheelCore.SLDPRT

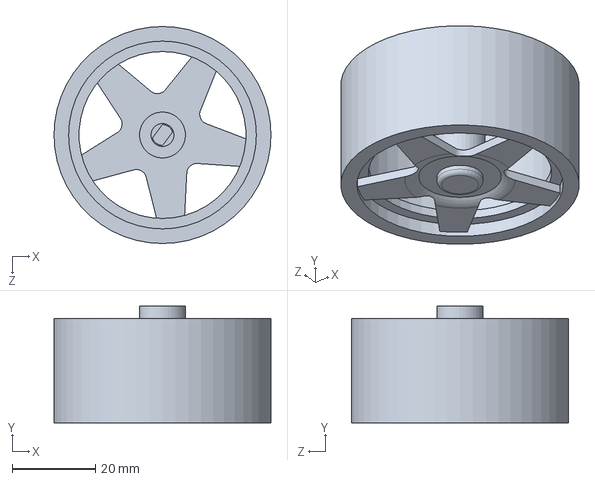
[picture p150: CAD file, 2018-04-25]
MotoModel/WheelCore.SLDPRT
52.0 x 28.0 x 52.0 mm
