thanh-pt/GraduationThesis/(list of files, cad)

Other CAD files:
MotoModel/moto_axis.SLDPRT
