thanh-pt/GraduationThesis/Doccument/stepMoto42.jpg

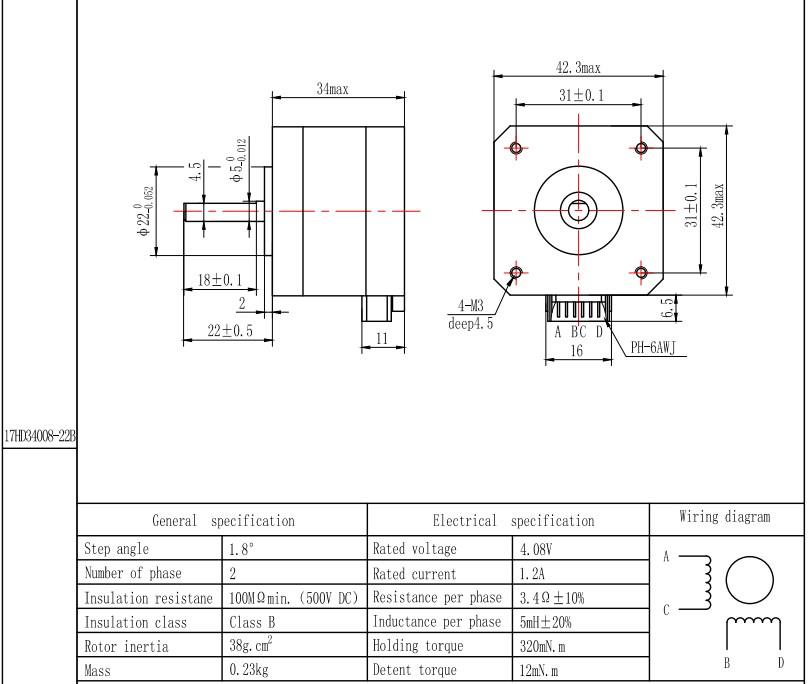
Doccument/stepMoto42.jpg
