thanh-pt/GraduationThesis/Doccument/TestingImage/StaticTest.png

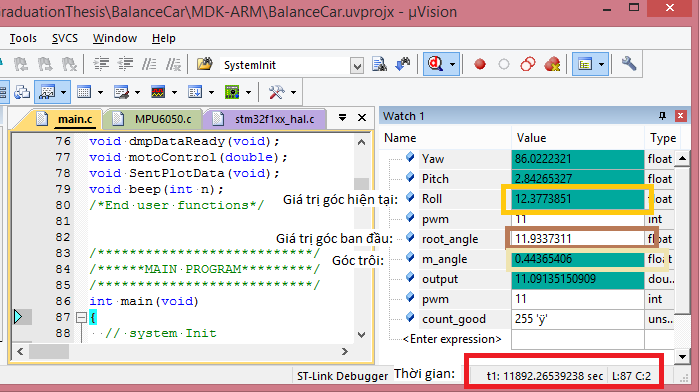
Doccument/TestingImage/StaticTest.png
