thanh-pt/GraduationThesis/(list of files, drawings)

Other design files:
CircuitDesign/BalanceCarCircuit.PcbDoc
CircuitDesign/BalanceCarCircuit.PrjPcb
CircuitDesign/BalanceCarCircuit.SchDoc
CircuitDesign/UnitLibrary.PcbLib
CircuitDesign/UnitLibrary.SchLib
