thanh-pt/GraduationThesis/BalanceCar/BalanceCar.ioc

Mcu.UserName=STM32F103C8Tx
PA0-WKUP.Signal=S_TIM2_CH1_ETR
PA1.Signal=GPIO_Output
PA10.Signal=USART1_RX
PA13.Signal=SYS_JTMS-SWDIO
PA14.Signal=SYS_JTCK-SWCLK
PA2.Signal=GPIO_Output
PA3.Signal=S_TIM2_CH4
PA4.Signal=GPIO_Output
PA5.Signal=GPIO_Output
PA9.Signal=USART1_TX
PB0.Signal=GPXTI0
PB6.Signal=I2C1_SCL
PB7.Signal=I2C1_SDA
PD0-OSC_IN.Signal=RCC_OSC_IN
PD1-OSC_OUT.Signal=RCC_OSC_OUT
