thanh-pt/GraduationThesis/(commit log)

2018-03-25 Upload Some doccument
    [PriceForProduct.xlsx]
2018-03-25 Upload AppControl [DESC][1] This is app in android device using bluetooth to receive and sent data to control
2018-03-25 Refactor code in Step motor control [DESC][0] Reorder some function and write some struct
2018-03-27 [Fix bug] Debug did not run
    [MPU6050.c, MotoControl.h, StepMotoControl.ioc, main.c]
2018-03-28 Make communication of device [DESC][0] Sent angle and velocity, acceleration [OK] [DESC][1] Sent request and receive data [OK] [DESC][2] Setup PID online [OK]
2018-04-02 Add Feature list for balance car
    [BalanceCarFeature.xlsx]
2018-04-02 Add Circuit design
    [BalanceCarCircuit.PrjPcb, BalanceCarCircuit.SchDoc, UnitLibrary.PcbLib, UnitLibrary.SchLib]
2018-04-03 Add PCB Doccument
    [BalanceCarCircuit.PcbDoc, BalanceCarCircuit.PrjPcb, BalanceCarCircuit.SchDoc, UnitLibrary.PcbLib, UnitLibrary.SchLib]
2018-04-03 Add circuit for MPU6050, HC05, L398
    [BalanceCarCircuit.PcbDoc, BalanceCarCircuit.SchDoc]
2018-04-08 break for a week
    [BalanceCarCircuit.PcbDoc]
2018-04-22 Update Documment::Stm32f103c8t6
2018-04-22 WriteDocumment::Introduce STM32CubeMx
2018-04-25 Creat Moto Model and update to Documment
    [BalanceCar.SLDASM, Gear.SLDASM, Gear_Moto.SLDASM, Gear_Moto_Wheel.SLDASM, HorizontalPlat.SLDPRT, MotoAxis.SLDPRT, MotoGear.SLDPRT, Wheel.SLDASM]
2018-04-30 stepMotoControl::Integrated control DC motor
2018-05-01 stepmotoControl::config PID
2018-05-06 too bad in PID
    prepare for demo false
